Godeta/spiderToKukaHand/tests/README.txt

Dossier Simu matlab:

	la simulation de deplacement du robot (lancer simulation_araigne.m)
	solution_traj.m défini les coef a,b et c pour la trajectoir en fonction carré

Simu to Arduino :

	com série Matlab - arduino

test_joystick_control :

	recup input de la manette
