Godeta/spiderToKukaHand/(commit log)

2024-12-04 ajout fichiers, projet presque fini manque double programme, code de l'arraignée par Nico et vidéos + rapport
2024-12-17 code arraignee marche, test matlab arduino pour arraignee ok puis changement mode ok plus qu'a combiner les deux et optimiser le code + faire une video
